xdylanm/shiftscaleinvert/README.md

# Shift Scale Invert (SSI)

A 4HP module for signal offsets and scaling.
