xdylanm/shiftscaleinvert/docs/assets/bom.csv

Reference | Qty | Value | Footprint
C1,C2,C3 | 3 | 22p | 0805
C4,C5,C6,C7,C8,C9,C10,C11 | 8 | 100n | 0805
C12,C13 | 2 | 10u | Radial D5.0mm P2.00mm
C14,C15 | 2 | 1u | 0805
D1,D2 | 2 | B140-E3 | SMA
FB1,FB2 | 2 | 470 | 0805
J1,J2,J3,J4,J5,J6 | 6 | Mono Jack | WQP-PJ301M-12
J7 | 1 | 02x05 | IDC Header 02x05 P2.54mm Vertical
R1,R2,R3,R4,R5,R7,R9,R10,R12,R13,R14,R16,R17,R18,R19,R20,R22,R23,R24,R25 | 20 | 100k | 0805
R6,R11,R15 | 3 | 49k9 | 0805
R8,R21,R26 | 3 | 1k | 0805
RV1,RV2,RV3 | 3 | 100k | PTV09A-1 Vertical
U1,U2,U3 | 3 | TL072 | SOIC-8
U5 | 1 | LDK320M5R | SOT-23-5
