xdylanm/shiftscaleinvert/docs/assets/schematic.pdf

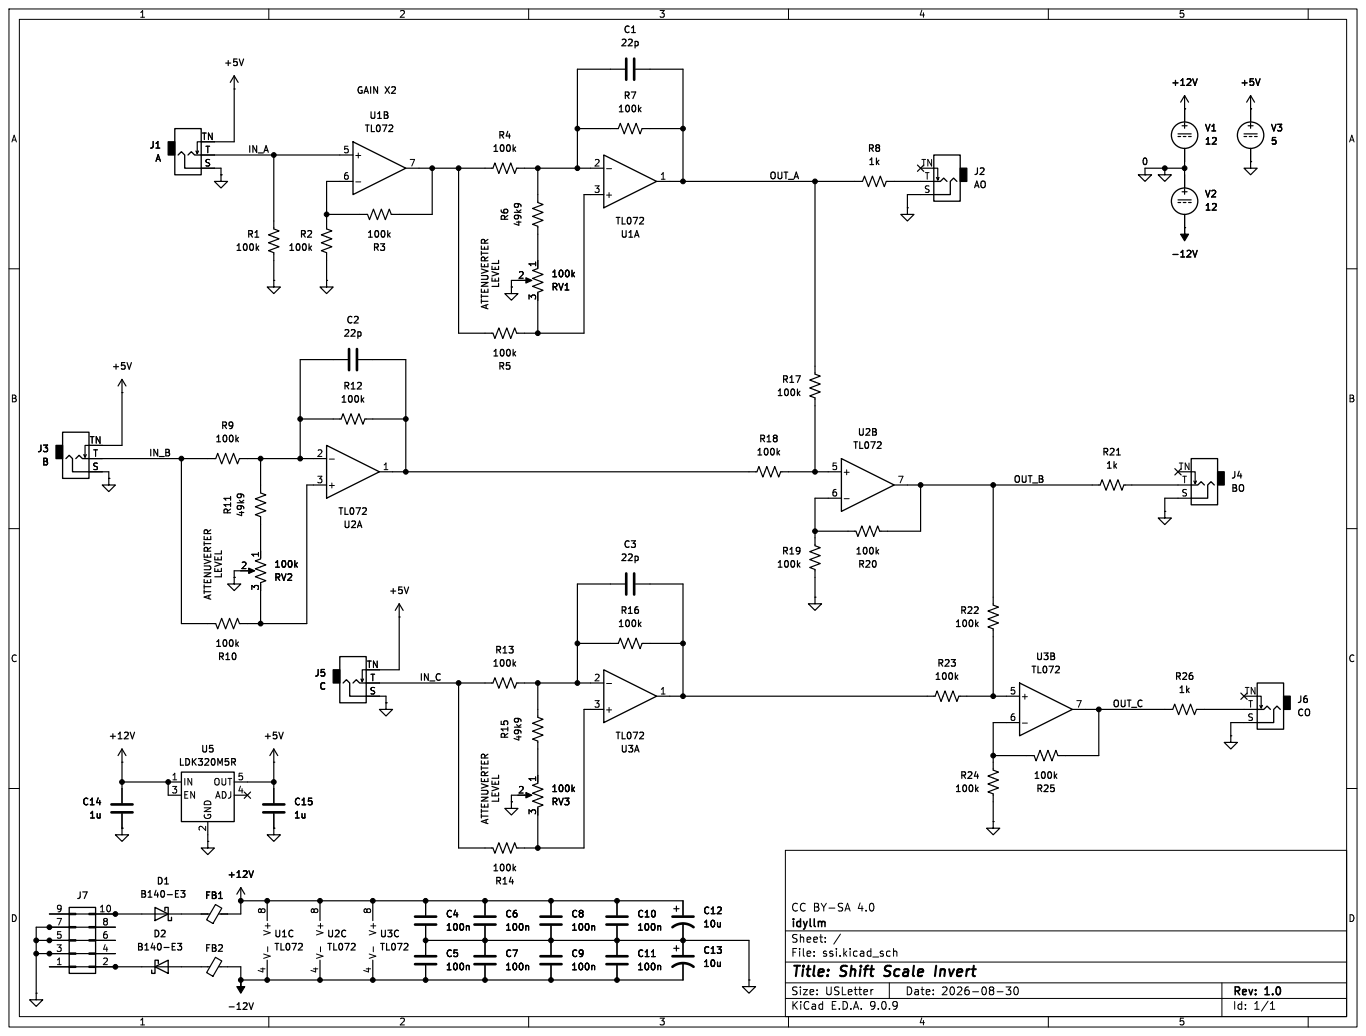
[picture p1: page 1]

idyllm
Id: 1/1 Title: Shift Scale Invert File: ssi.kicad_sch Sheet: /
