xdylanm/shiftscaleinvert/hardware/ssi/ssi.kicad_pcb

## KiCad design hardware/ssi/ssi.kicad_pcb (2026-10-30)

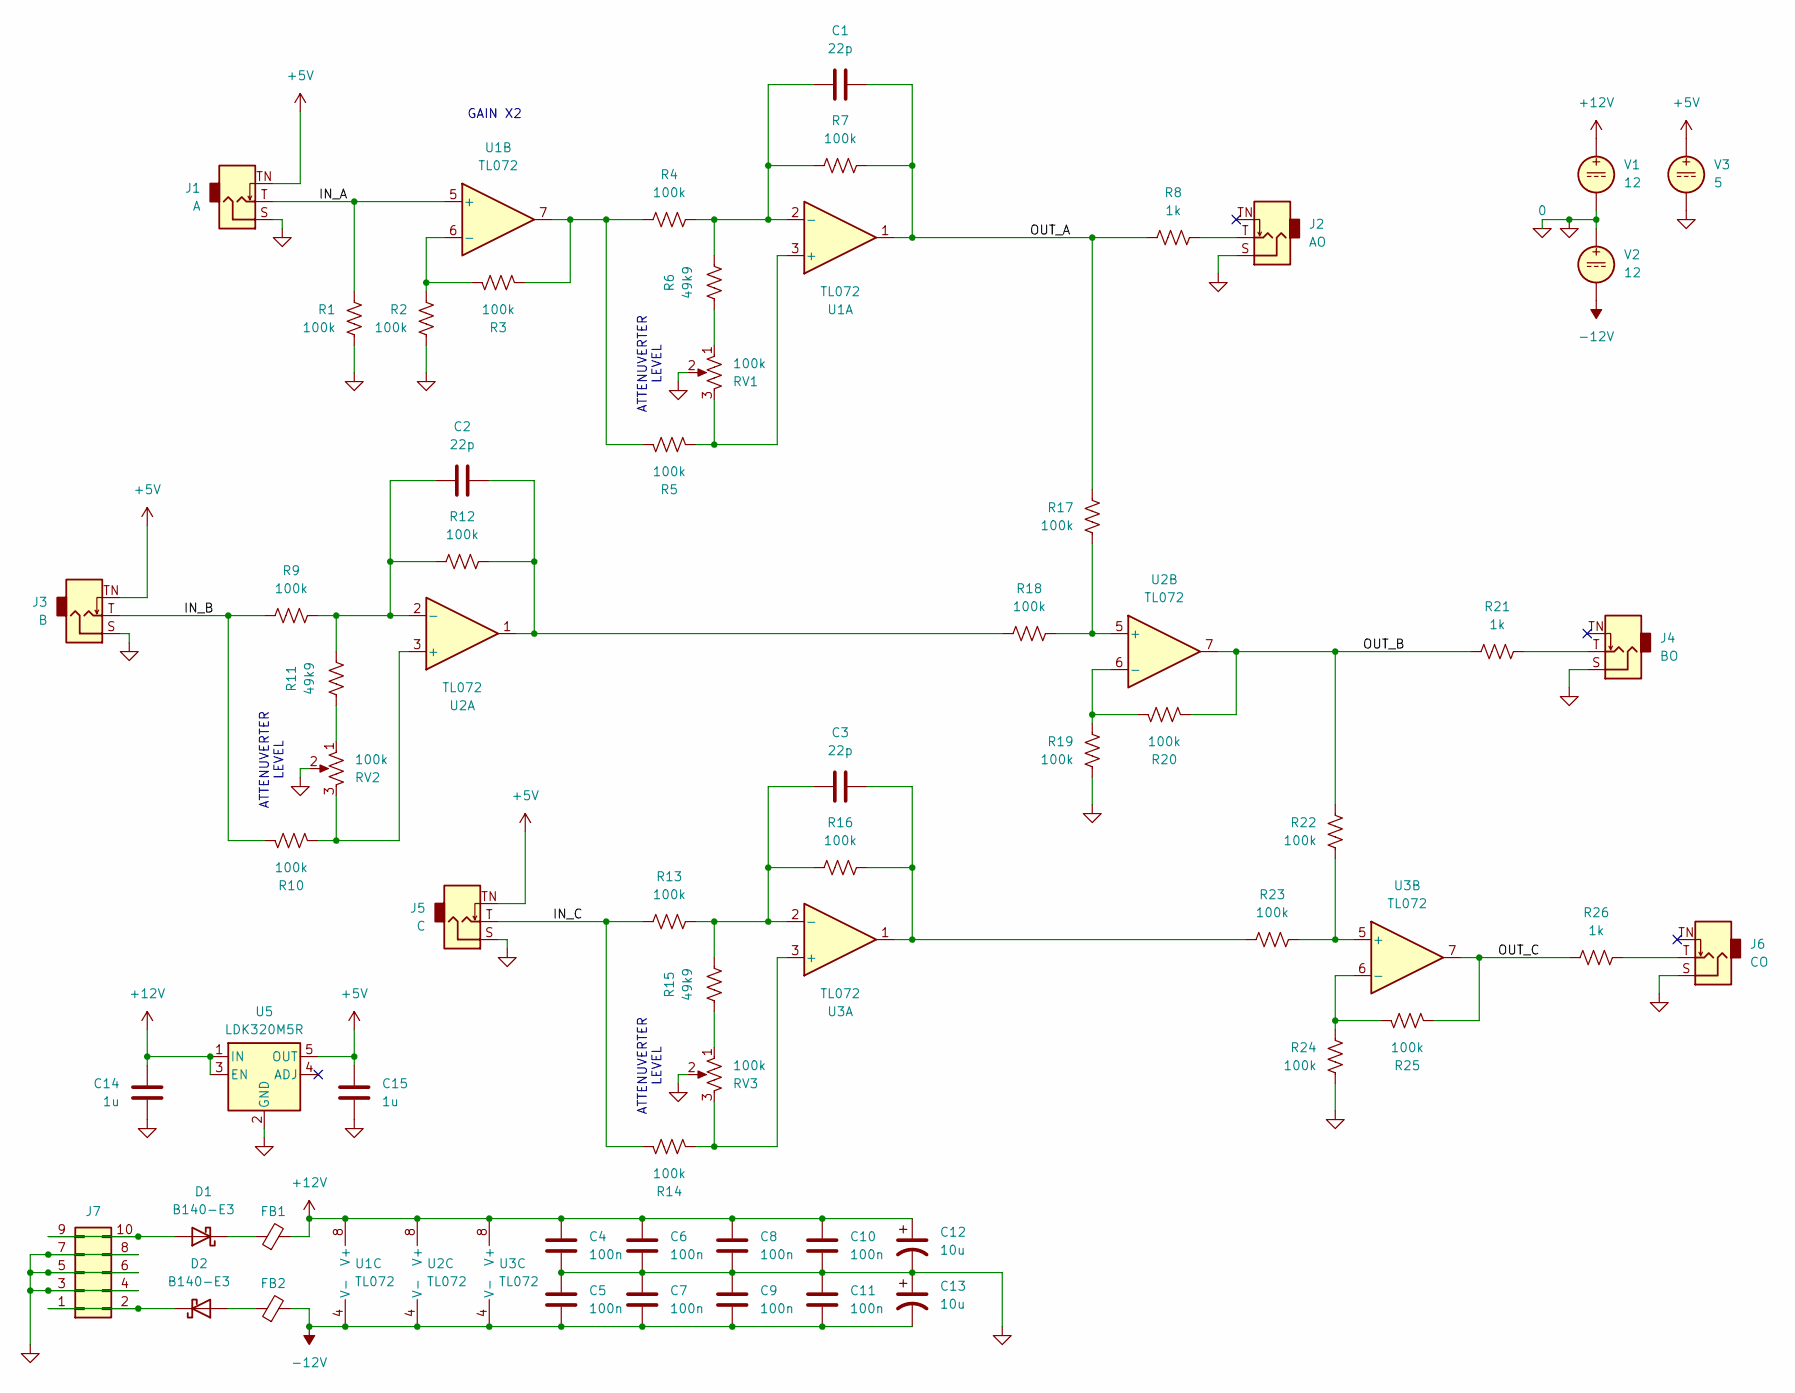
[picture p2: schematic ssi.kicad_sch, Shift Scale Invert]

Parts:
C1, C2, C3: 22p; C_0805_2012Metric_Pad1.18x1.45mm_HandSolder
C4, C5, C6, C7, C8, C9, C10, C11: 100n; C_0805_2012Metric_Pad1.18x1.45mm_HandSolder
C12, C13: 10u; CP_Radial_D5.0mm_P2.00mm
C14, C15: 1u; C_0805_2012Metric_Pad1.18x1.45mm_HandSolder
D1, D2: B140-E3; D_SMA
FB1, FB2: FerriteBead_Small; L_0805_2012Metric_Pad1.05x1.20mm_HandSolder
J1: A; Jack_3.5mm_QingPu_WQP-PJ301M-12_Vertical_Slim
J2: AO; Jack_3.5mm_QingPu_WQP-PJ301M-12_Vertical_Slim
J3: B; Jack_3.5mm_QingPu_WQP-PJ301M-12_Vertical_Slim
J4: BO; Jack_3.5mm_QingPu_WQP-PJ301M-12_Vertical_Slim
J5: C; Jack_3.5mm_QingPu_WQP-PJ301M-12_Vertical_Slim
J6: CO; Jack_3.5mm_QingPu_WQP-PJ301M-12_Vertical_Slim
J7: Conn_02x05_Odd_Even; IDC-Header_2x05_P2.54mm_Vertical
R1, R2, R3, R4, R5, R7, R9, R10, R12, R13, R14, R16, R17, R18, R19, R20, R22, R23, R24, R25: 100k; R_0805_2012Metric_Pad1.20x1.40mm_HandSolder
R6, R11, R15: 49k9; R_0805_2012Metric_Pad1.20x1.40mm_HandSolder
R8, R21, R26: 1k; R_0805_2012Metric_Pad1.20x1.40mm_HandSolder
RV1, RV2, RV3: 100k; Potentiometer_Bourns_PTV09A-1_Single_Vertical_thin
U1, U2, U3: TL072; SOIC-8_3.9x4.9mm_P1.27mm
U5: LDK320M5R; SOT-23-5_HandSoldering
V1, V2: 12
V3: 5

Connections:
0: C4.2, C5.1, C6.2, C7.1, C8.2, C9.1, C10.2, C11.1, C12.2, C13.1, C14.2, C15.2, J1.S, J2.S, J3.S, J4.S, J5.S, J6.S, J7.3, J7.4, J7.5, J7.6, J7.7, J7.8, R1.2, R2.2, R19.2, R24.2, RV1.2, RV1.MP, RV2.2, RV2.MP, RV3.2, RV3.MP, U5.2 (GND), V1.2, V2.1, V3.2
+5V: C15.1, J1.TN, J3.TN, J5.TN, U5.5 (OUT), V3.1
+12V: C4.1, C6.1, C8.1, C10.1, C12.1, C14.1, FB1.2, U1.8 (V+), U2.8 (V+), U3.8 (V+), U5.1 (IN), U5.3 (EN), V1.1
-12V: C5.2, C7.2, C9.2, C11.2, C13.2, FB2.2, U1.4 (V-), U2.4 (V-), U3.4 (V-), V2.2
/IN_A: J1.T, R1.1, U1.5 (+)
/IN_B: J3.T, R9.1, R10.1
/IN_C: J5.T, R13.1, R14.1
/OUT_A: C1.2, R7.2, R8.1, R17.1, U1.1
/OUT_B: R20.2, R21.1, R22.1, U2.7
/OUT_C: R25.2, R26.1, U3.7
unnamed: C2.2, R12.2, R18.1, U2.1
unnamed: C3.2, R16.2, R23.1, U3.1
unnamed: D1.2 (A), J7.9, J7.10
unnamed: D1.1 (K), FB1.1
unnamed: D2.2 (A), FB2.1
unnamed: D2.1 (K), J7.1, J7.2
unnamed: J2.T, R8.2
unnamed: J4.T, R21.2
unnamed: J6.T, R26.2
unnamed: R3.2, R4.1, R5.1, U1.7
unnamed: R6.1, RV1.1
unnamed: R11.1, RV2.1
unnamed: R15.1, RV3.1
unnamed: R5.2, RV1.3, U1.3 (+)
unnamed: C1.1, R4.2, R6.2, R7.1, U1.2 (-)
unnamed: R2.1, R3.1, U1.6 (-)
unnamed: R10.2, RV2.3, U2.3 (+)
unnamed: C2.1, R9.2, R11.2, R12.1, U2.2 (-)
unnamed: R17.2, R18.2, U2.5 (+)
unnamed: R19.1, R20.1, U2.6 (-)
unnamed: R14.2, RV3.3, U3.3 (+)
unnamed: C3.1, R13.2, R15.2, R16.1, U3.2 (-)
unnamed: R22.2, R23.2, U3.5 (+)
unnamed: R24.1, R25.1, U3.6 (-)

Notes on the sheet:
ATTENUVERTER LEVEL
GAIN X2

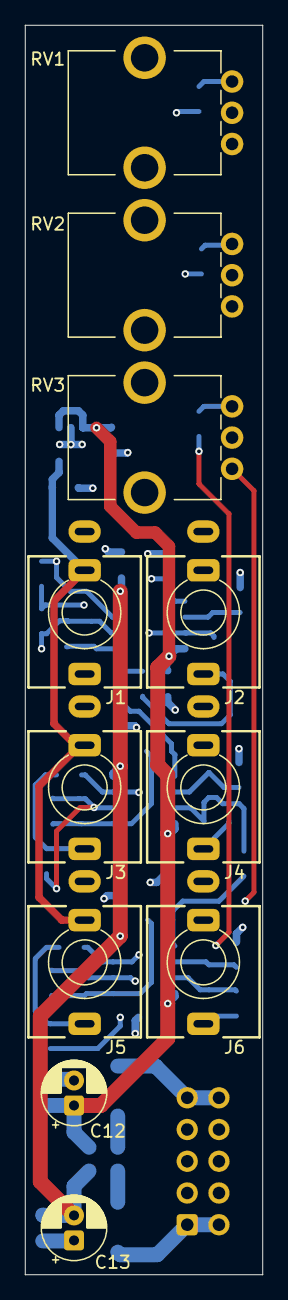
[picture p3: board ssi.kicad_pcb from above]

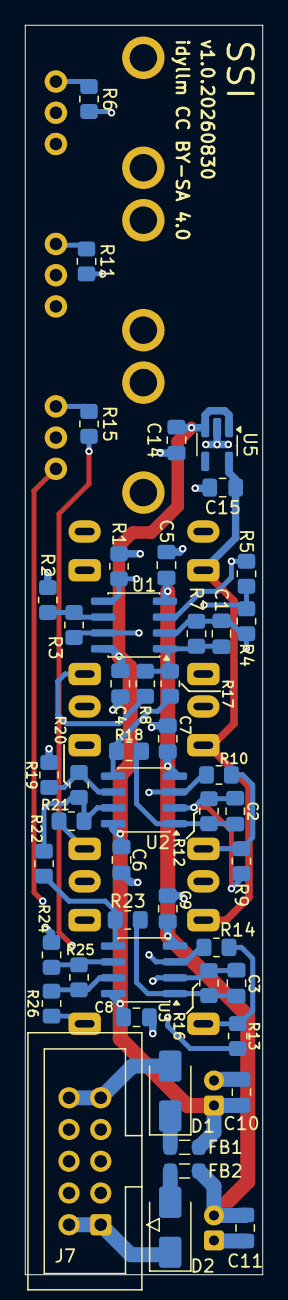
[picture p4: board ssi.kicad_pcb from below]

Board: 4 copper layers, 19.0 x 100.0 mm, 59 parts (48 on the bottom side), 34 nets.
