xdylanm/shiftscaleinvert/(notices)

Notices in the files:
hardware/ssi/ssi.kicad_pcb:
CC BY-SA 4.0
idyllm CC BY-SA 4.0
